JuanHauara/LCD_adapter_board_for_FPGA_dev_board/doc/Pantalla_LCD/IMG_20261008_131609.jpg

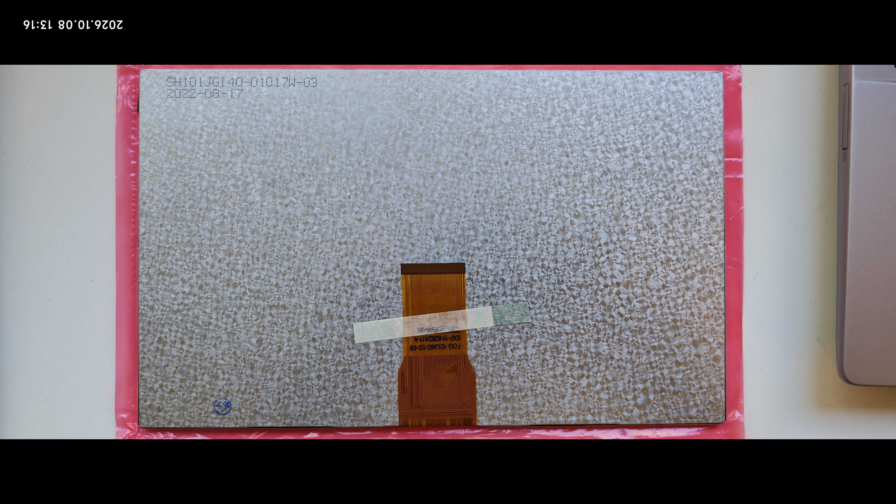
doc/Pantalla_LCD/IMG_20261008_131609.jpg
