JuanHauara/LCD_adapter_board_for_FPGA_dev_board/(list of files, drawings)

Other design files:
LCD_adapter_board_for_FPGA_dev_board.PrjPcb
LCD_backlight_power.SchDoc
LCD_power_supplies.SchDoc
LCD_RGB_parallel_connector.SchDoc
PCB.PcbDoc
