JuanHauara/LCD_adapter_board_for_FPGA_dev_board/(commit log)

2026-10-26 Refactor backlight feedback regulation circuit.
    [LCD_RGB_parallel_connector.SchDoc, LCD_adapter_board_for_FPGA_dev_board.PrjPcb, LCD_backlight_power.SchDoc, LCD_power_supplies.SchDoc]
2026-10-27 Work on LCD power supplies.
    [LCD_backlight_power.SchDoc, LCD_power_supplies.SchDoc]
2026-10-28 Connect VCOM schematic.
    [LCD_backlight_power.SchDoc, LCD_power_supplies.SchDoc]
2026-10-28 Use trimpots to adjust the voltages of the TPS65150.
    [LCD_RGB_parallel_connector.SchDoc, LCD_power_supplies.SchDoc]
2026-10-28 Conectar tensiónes de alimentación al zócalo del LCD.
    [LCD_RGB_parallel_connector.SchDoc, LCD_power_supplies.SchDoc]
2026-10-28 Anotate schematics.
    [LCD_RGB_parallel_connector.SchDoc, LCD_adapter_board_for_FPGA_dev_board.PrjPcb, LCD_backlight_power.SchDoc, LCD_power_supplies.SchDoc]
2026-10-28 Connect MIC5235YM5 LDO enable pin.
    [LCD_RGB_parallel_connector.SchDoc, LCD_power_supplies.SchDoc]
2026-10-28 Put 10k pull-down on reset pin.
    [LCD_RGB_parallel_connector.SchDoc, LCD_backlight_power.SchDoc, LCD_power_supplies.SchDoc]
2026-10-28 Add switch to power ON/OFF the LCD.
    [LCD_RGB_parallel_connector.SchDoc, LCD_backlight_power.SchDoc, LCD_power_supplies.SchDoc]
2026-10-29 Put test points.
    [LCD_adapter_board_for_FPGA_dev_board.PrjPcb, LCD_backlight_power.SchDoc, LCD_power_supplies.SchDoc, PCB.PcbDoc]
2026-10-29 Fix slide switch footprint and trimpot pinout.
    [LCD_RGB_parallel_connector.SchDoc, LCD_backlight_power.SchDoc, LCD_power_supplies.SchDoc, PCB.PcbDoc]
2026-10-29 Reduce text to 1.2mm
    [PCB.PcbDoc]
2026-10-29 Change R1 footprint.
    [LCD_RGB_parallel_connector.SchDoc, LCD_backlight_power.SchDoc, PCB.PcbDoc]
2026-10-29 Group TPS61165 components.
    [PCB.PcbDoc]
2026-10-29 Route TPS61165 circuit.
    [LCD_RGB_parallel_connector.SchDoc, LCD_backlight_power.SchDoc, PCB.PcbDoc]
2026-10-30 Route L2, D2
    [PCB.PcbDoc]
2026-10-30 Route main step up converter.
    [PCB.PcbDoc]
2026-10-30 Route VCOM.
    [LCD_backlight_power.SchDoc, LCD_power_supplies.SchDoc, PCB.PcbDoc]
2026-10-31 Route P1 pins.
    [LCD_RGB_parallel_connector.SchDoc, PCB.PcbDoc]
2026-10-31 Fix FBN pin not connected.
    [LCD_power_supplies.SchDoc, PCB.PcbDoc]
2026-10-31 Route VGL and VGH.
    [LCD_power_supplies.SchDoc, PCB.PcbDoc]
2026-10-31 Remove P6.
    [LCD_power_supplies.SchDoc, PCB.PcbDoc]
2026-10-31 Route complete.
    [LCD_power_supplies.SchDoc, PCB.PcbDoc]
